tgtakaoka/Cyborg09/CyborgHD6309E/Prototype3/schematic/Prototype3.kicad_pcb

## KiCad design CyborgHD6309E/Prototype3/schematic/Prototype3.kicad_pcb (2021-06-11, an earlier design)

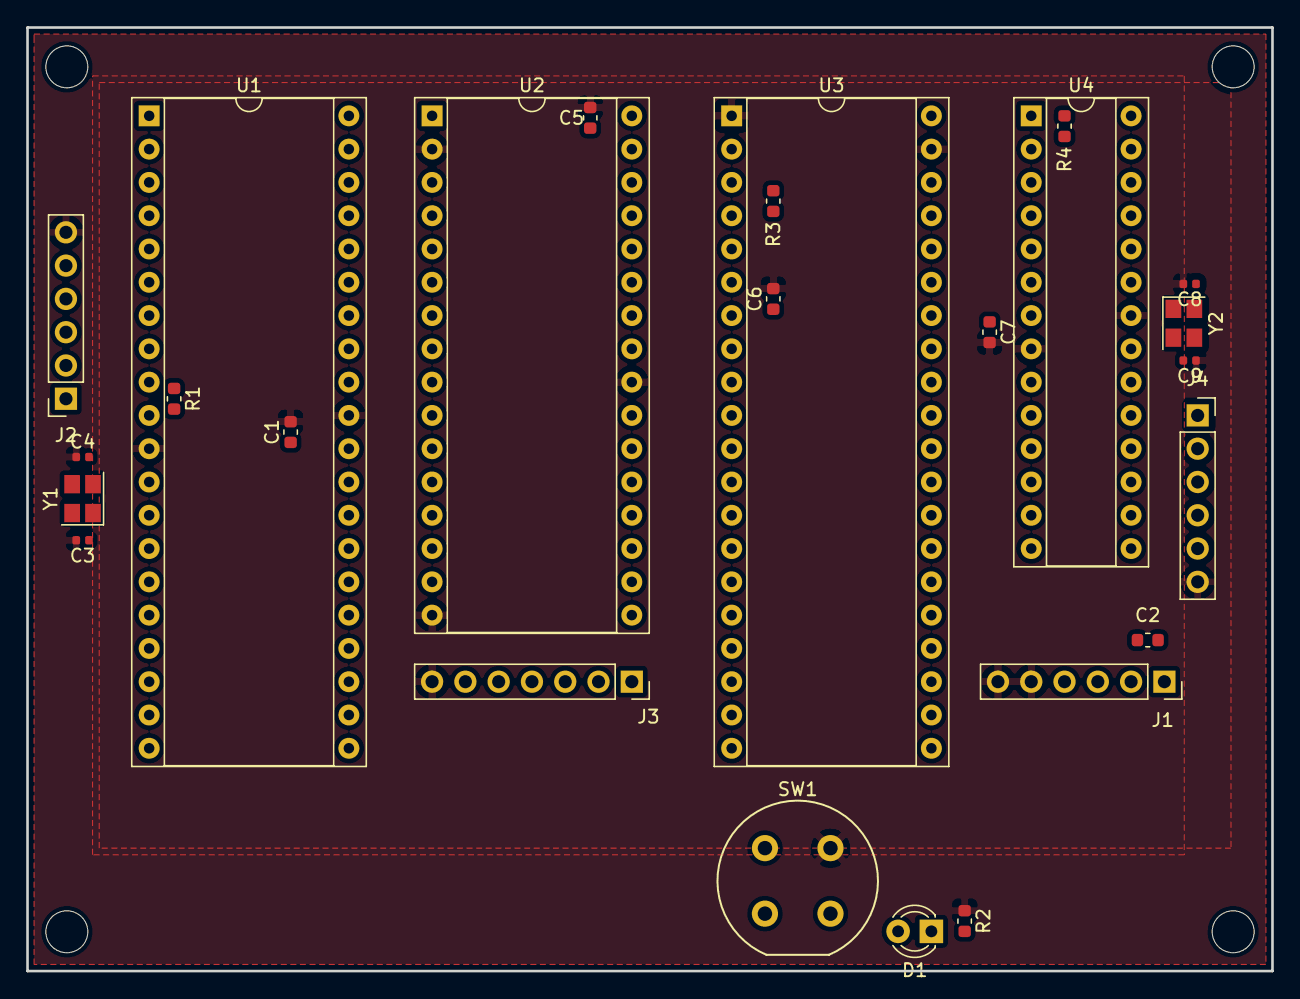
[picture p1: board Prototype3.kicad_pcb from above]

Board: 2 copper layers, 95.0 x 72.0 mm, 29 parts (0 on the bottom side), 59 nets, no tracks yet.

Parts:
C1, C2, C5, C6, C7: 0.1u; C_0603_1608Metric
C3, C4, C8, C9: 22p; C_0402_1005Metric
D1: USR_LED; LED_D3.0mm
J1: Conn_USB_Serial; PinSocket_1x06_P2.54mm_Vertical
J2, J4: Conn_AVR_ISP; PinSocket_1x06_P2.54mm_Vertical
J3: Conn_Micro_SD; PinSocket_1x07_P2.54mm_Vertical
MH1, MH2, MH3, MH4: MountingHole_3.2mm_M3
R1, R3, R4: 10k; R_0603_1608Metric
R2: 560; R_0603_1608Metric
SW1: USR_SW; Push_E-Switch_KS01Q01
U1: ATmega1284P-PU; DIP-40_W15.24mm_Socket
U2: HM628128DLP-5; DIP-32_W15.24mm_Socket
U3: HD63C09E; DIP-40_W15.24mm_Socket
U4: ATmega328P-PU; DIP-28_W7.62mm_Socket
Y1, Y2: 20MHz; Crystal_SMD_SeikoEpson_FA238-4Pin_3.2x2.5mm

Connections:
/A0: U1.3, U2.12, U3.8
/A1: U1.4, U2.11, U3.9
/A2: J4.4, U2.10, U3.10, U4.18
/A3: J4.5, U2.9, U3.11, U4.17
/A4: U2.8, U3.12, U4.16
/A5: U2.7, U3.13, U4.2
/A6: U2.6, U3.14, U4.15
/A7: J4.3, U2.5, U3.15, U4.19
/A8: U2.27, U3.16, U4.14
/A9: U2.26, U3.17, U4.3
/A10: U2.23, U3.18, U4.4
/A11: U2.25, U3.19, U4.5
/A12: U2.4, U3.20, U4.6
/A13: U2.28, U3.21, U4.11
/A14: U2.3, U3.22, U4.12
/A15: U2.31, U3.23, U4.13
/AVMA: U1.26, U3.36
/BA: U1.27, U3.6
/BS: U1.29, U3.5
/BUSY: U1.25, U3.33
/D0: U1.40, U2.13, U3.31
/D1: U1.39, U2.14, U3.30
/D2: U1.38, U2.15, U3.29
/D3: U1.37, U2.17, U3.28
/D4: U1.36, U2.18, U3.27
/D5: U1.35, U2.19, U3.26
/D6: U1.34, U2.20, U3.25
/D7: U1.33, U2.21, U3.24
/DBG_RX: J1.3, U1.14
/DBG_TX: J1.2, U1.15
/E_CLK: U2.30, U3.34, U4.27
/LIC: U1.28, U3.38
/Q_CLK: U3.35, U4.28
/RD_WR: U1.24, U2.29, U3.32
/SD_DI: J2.5, J3.3, U1.6
/SD_DO: J2.4, J3.5, U1.7
/SD_SCK: J2.3, J3.4, U1.8
/USR_LED: D1.2, U1.18
/~ACK~: U1.20, U4.25
/~DBG_RST~: C2.2, J2.1, R1.1, U1.9
/~HALT~: U1.23, U3.40
/~INT~: U1.17, U4.26
/~IRQ: U1.2, U3.3
/~NMI~: U1.1, U3.2
/~RAM_E~: U1.19, U2.22
/~RESET~: U1.22, U3.37
/~SD_CS~: J3.2, U1.5
/~STEP~: U1.21, U4.24
/~USR_SW~: SW1.1, U1.16
GND: C1.2, C3.2, C4.1, C5.2, C6.2, C7.2, C8.2, C9.1, J1.5, J1.6, J2.6, J3.7, J4.6, R2.1, SW1.2, U1.11, U1.31, U2.2, U2.16, U2.24, U3.1, U3.39, U4.8, U4.22
unnamed: C2.1, J1.1
unnamed: C3.1, U1.13, Y1.1
unnamed: C4.2, U1.12, Y1.2
unnamed: C8.1, U4.9, Y2.1
unnamed: C9.2, U4.10, Y2.2
unnamed: D1.1, R2.2
unnamed: J4.1, R4.1, U4.1
unnamed: R3.1, U3.4
VCC: C1.1, C5.1, C6.1, C7.1, J1.4, J2.2, J3.1, J4.2, R1.2, R3.2, R4.2, U1.10, U1.30, U2.32, U3.7, U4.7, U4.20
