tgtakaoka/Cyborg09/CyborgHD6309E/Prototype4/schematic/Prototype4.kicad_pcb

## KiCad design CyborgHD6309E/Prototype4/schematic/Prototype4.kicad_pcb (2021-06-11, an earlier design)

Schematic: Prototype4.sch, CyborgHD6309E Prototype4

Parts:
B1: Micro_SD; uSD_CARD
B2: USB_Serial; GY232V2
C1, C2, C3, C4, C5, C6, C7: 0.1u; C_Disc_D3.4mm_W2.1mm_P2.50mm
J1: Conn_AVR_UPDI; PinSocket_1x03_P2.54mm_Vertical
R2, R3: 10k; R_Axial_DIN0204_L3.6mm_D1.6mm_P5.08mm_Horizontal
R6: 560; R_Axial_DIN0204_L3.6mm_D1.6mm_P5.08mm_Horizontal
SW1: TSD1265; SW_PUSH-LED-12mm
U1: ATmega4809-P; DIP-40_W15.24mm
U2: HM628128DLP-5; DIP-32_W15.24mm_Socket
U3: HD63C09E; DIP-40_W15.24mm_Socket
U4: ATtiny412-SS; DIP-8_W7.62mm
U5: CD74HCT30; DIP-14_W7.62mm
U6: CD74HCT688; DIP-20_W7.62mm

Connections:
/A0: U1.7 (PC4), U2.26 (A9), U3.8 (A0)
/A1: U1.8 (PC5), U2.25 (A11), U3.9 (A1)
/A2: U2.23 (A10), U3.10 (A2)
/A3: U2.3 (A14), U3.11 (A3), U6.17 (A7)
/A4: U2.4 (A12), U3.12 (A4), U6.15 (A6)
/A5: U2.5 (A7), U3.13 (A5), U6.13 (A5)
/A6: U2.6 (A6), U3.14 (A6), U6.11 (A4)
/A7: U2.7 (A5), U3.15 (A7), U6.8 (A3)
/A8: U2.8 (A4), U3.16 (A8), U5.12
/A9: U2.9 (A3), U3.17 (A9), U5.11
/A10: U2.10 (A2), U3.18 (A10), U5.1
/A11: U2.11 (A1), U3.19 (A11), U5.2
/A12: U2.12 (A0), U3.20 (A12), U5.3
/A13: U2.27 (A8), U3.21 (A13), U5.6
/A14: U2.28 (A13), U3.22 (A14), U5.5
/A15: U2.31 (A15), U3.23 (A15), U5.4
/AVMA: U1.12 (PD3), U3.36 (AVMA)
/BA: U1.14 (PD5), U3.6 (BA)
/BS: U1.13 (PD4), U3.5 (BS)
/BUSY: U1.16 (PD7), U3.33 (BUSY)
/D0: U1.33 (PA0), U2.21 (Q7), U3.31 (D0)
/D1: U1.34 (PA1), U2.20 (Q6), U3.30 (D1)
/D2: U1.35 (PA2), U2.19 (Q5), U3.29 (D2)
/D3: U1.36 (PA3), U2.18 (Q4), U3.28 (D3)
/D4: U1.37 (PA4), U2.17 (Q3), U3.27 (D4)
/D5: U1.38 (PA5), U2.13 (Q0), U3.26 (D5)
/D6: U1.39 (PA6), U2.14 (Q1), U3.25 (D6)
/D7: U1.40 (PA7), U2.15 (Q2), U3.24 (D7)
/DBG_RX: B2.4 (TXD), U1.1 (PC0/TXD)
/DBG_TX: B2.5 (RXD), U1.2 (PC1/RXD)
/E_CLK: U2.30 (CS2), U3.34 (E), U4.3 (PA7)
/LIC: U1.10 (PD1), U3.38 (LIC)
/Q_CLK: U3.35 (Q), U4.4 (PA1)
/RD_WR: U1.11 (PD2), U2.29 (WR), U3.32 (R/~W)
/SD_DI: B1.3 (DI), U1.19 (MOSI/PE0)
/SD_DO: B1.5 (DO), U1.20 (MISO/PE1)
/SD_SCK: B1.4 (SCK), U1.21 (SCK/PE2)
/USR_LED: R6.2, U1.27 (PF4)
/~ACK~: U1.3 (PC2/SDA), U4.6 (UPDI/PA0)
/~DBG_RESET~: C7.2, R3.1, U1.29 (~RESET~/PF6)
/~HALT~: U1.15 (PD6), U3.40 (~HALT)
/~INT~: U1.25 (PF2), U4.7 (PA3)
/~IRQ~: U1.23 (PF0), U3.3 (~IRQ)
/~NMI~: U1.24 (PF1), U3.2 (~NMI)
/~RAM_E~: U1.4 (PC3/SCL), U2.22 (CS1)
/~RESET~: U1.9 (PD0), U3.37 (~RESET)
/~SD_CS~: B1.2 (~CS), U1.22 (SS/PE3)
/~STEP~: U1.26 (PF3), U4.5 (PA2)
/~USR_SW~: SW1.2, U1.28 (PF5)
GND: B1.7 (GND), B2.1 (GND), B2.2 (~CTS~), C1.2, C2.2, C3.2, C4.2, C5.2, C6.2, J1.2 (GND), SW1.1, SW1.3 (K), U1.6 (GND), U1.18 (GND), U1.32 (GND), U2.2 (A16), U2.16 (GND), U2.24 (OE), U3.1 (VSS), U3.39 (TSC), U4.8 (GND), U5.7 (GND), U6.2 (A0), U6.3 (B0), U6.4 (A1), U6.5 (B1), U6.6 (A2), U6.7 (B2), U6.10 (GND), U6.14 (B5), U6.16 (B6), U6.18 (B7)
unnamed: B2.6 (~DTR~), C7.1
unnamed: J1.1 (UPDI), U1.30 (UPDI)
unnamed: R2.2, U3.4 (~FIRQ)
unnamed: R6.1, SW1.4 (A)
unnamed: U4.2 (PA6), U6.19 (~Y~)
unnamed: U5.8, U6.1 (~E~)
VCC: B1.1 (VCC), B2.3 (5V0), C1.1, C2.1, C3.1, C4.1, C5.1, C6.1, J1.3 (VCC), R2.1, R3.2, U1.5 (VCC), U1.17 (AVCC), U1.31 (VCC), U2.32 (VCC), U3.7 (VCC), U4.1 (VCC), U5.14 (VCC), U6.9 (B3), U6.12 (B4), U6.20 (VCC)

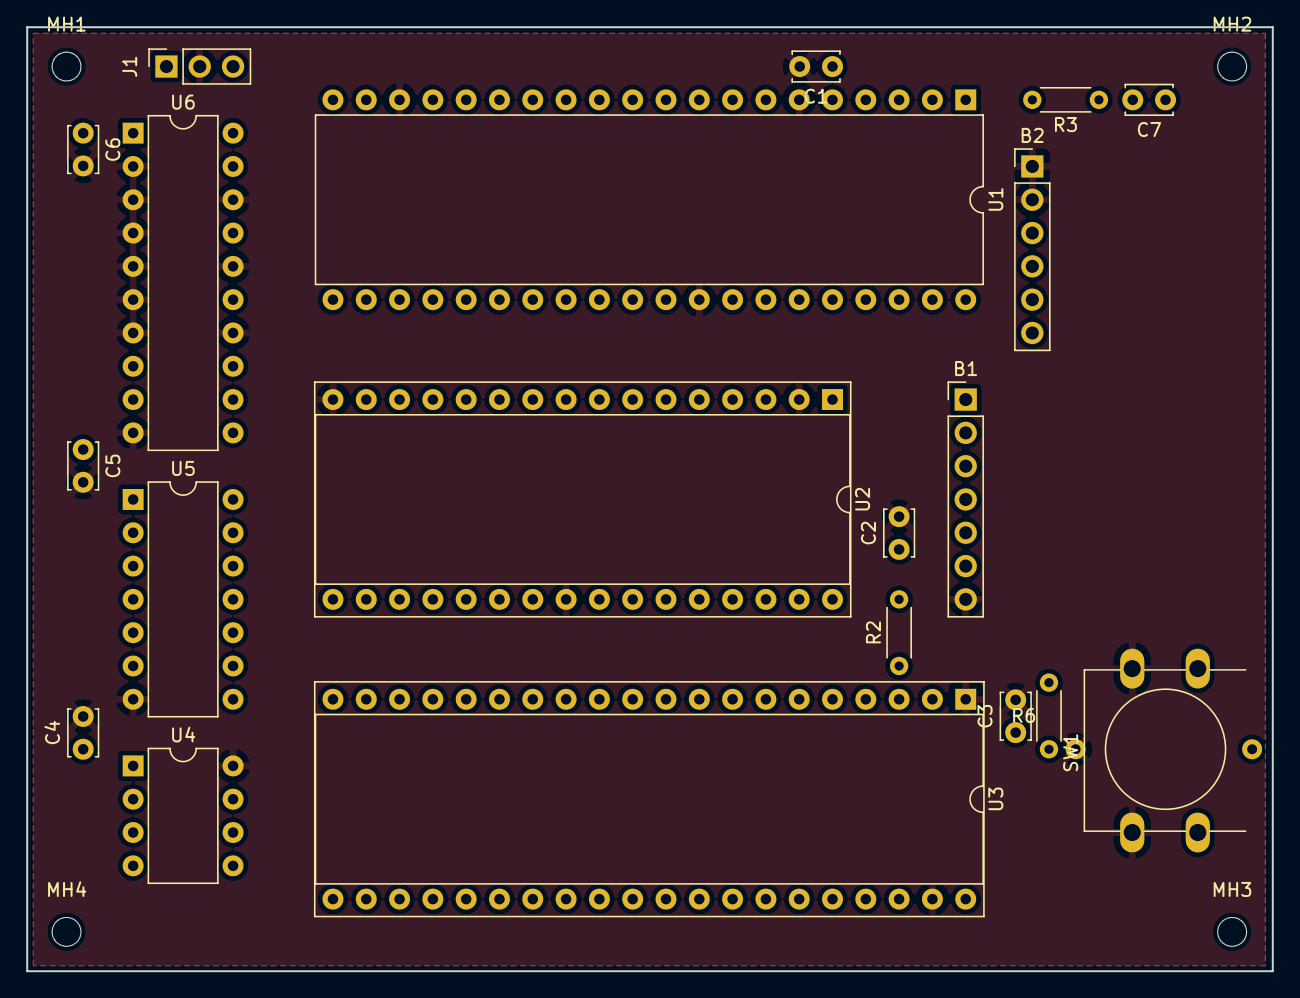
[picture p2: board Prototype4.kicad_pcb from above]

Board: 2 copper layers, 95.0 x 72.0 mm, 24 parts (0 on the bottom side), 57 nets, no tracks yet.

Other parts of the board:
MH1, MH2, MH3, MH4: MountingHole_2.2mm_M2
