tgtakaoka/Cyborg09/BionicHD6303/schematic/Prototype1.kicad_pcb

## KiCad design BionicHD6303/schematic/Prototype1.kicad_pcb (2021-01-31)

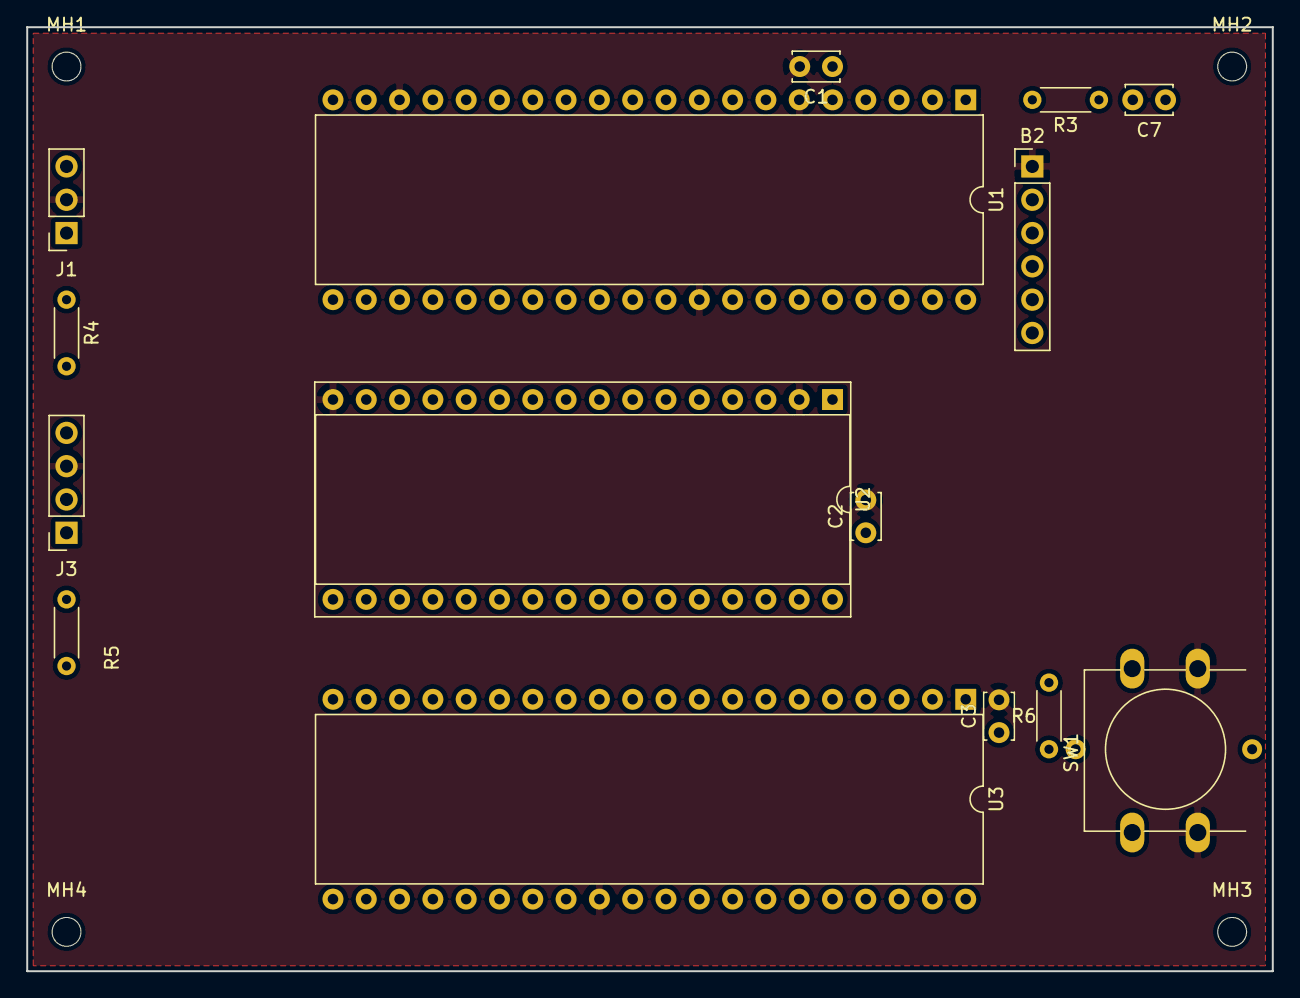
[picture p3: board Prototype1.kicad_pcb from above]

Board: 2 copper layers, 95.0 x 72.0 mm, 19 parts (0 on the bottom side), 50 nets, no tracks yet.

Parts:
B2: USB_Serial; GY232V2
C1, C2, C3, C7: 0.1u; C_Disc_D3.4mm_W2.1mm_P2.50mm
J1: Conn_AVR_UPDI; PinSocket_1x03_P2.54mm_Vertical
J3: Conn_I2C_Master; PinSocket_1x04_P2.54mm_Vertical
MH1, MH2, MH3, MH4: MountingHole_2.2mm_M2
R3: 10k; R_Axial_DIN0204_L3.6mm_D1.6mm_P5.08mm_Horizontal
R4, R5: 4k7; R_Axial_DIN0204_L3.6mm_D1.6mm_P5.08mm_Horizontal
R6: 560; R_Axial_DIN0204_L3.6mm_D1.6mm_P5.08mm_Horizontal
SW1: TSD1265; SW_PUSH-LED-12mm
U1: ATmega4809-P; DIP-40_W15.24mm
U2: HM628128DLP-5; DIP-32_W15.24mm_Socket
U3: Z84C00; DIP-40_W15.24mm

Connections:
/A0: U1.25, U2.26, U3.30
/A1: U1.26, U2.25, U3.31
/A2: U2.23, U3.32
/A3: U2.3, U3.33
/A4: U2.4, U3.34
/A5: U2.5, U3.35
/A6: U2.6, U3.36
/A7: U2.7, U3.37
/A8: U2.8, U3.38
/A9: U2.9, U3.39
/A10: U2.10, U3.40
/A11: U2.11, U3.1
/A12: U2.12, U3.2
/A13: U2.27, U3.3
/A14: U2.28, U3.4
/A15: U2.31, U3.5
/CLK: U1.28, U3.6
/D0: U1.9, U2.21, U3.14
/D1: U1.10, U2.20, U3.15
/D2: U1.11, U2.19, U3.12
/D3: U1.12, U2.18, U3.8
/D4: U1.13, U2.17, U3.7
/D5: U1.14, U2.13, U3.9
/D6: U1.15, U2.14, U3.10
/D7: U1.16, U2.15, U3.13
/DBG_RX: B2.4, U1.1
/DBG_TX: B2.5, U1.2
/SCL: J3.4, R4.2
/SDA: J3.1, R5.2
/~BUSACK~: U1.40, U3.23
/~BUSREQ~: U1.39, U3.25
/~DBG_RESET~: C7.2, R3.1, U1.29
/~DBG_RTS~: B2.2, U1.8
/~INT~: U1.23, U3.16
/~IORQ~: U1.33, U3.20
/~M1~: U1.35, U3.27
/~MREQ~: U1.34, U3.19
/~NMI~: U1.24, U3.17
/~RAM_E~: U1.3, U2.22
/~RD~: U1.37, U2.24, U3.21
/~RESET~: U1.27, U3.26
/~USR_LED~: R6.2, U1.7
/~USR_SW~: SW1.1, U1.4
/~WAIT~: U1.36, U3.24
/~WR~: U1.38, U2.29, U3.22
GND: B2.1, C1.2, C2.2, C3.2, J1.2, J3.3, SW1.2, U1.6, U1.18, U1.32, U2.2, U2.16, U3.29
unnamed: B2.6, C7.1
unnamed: J1.1, U1.30
unnamed: R6.1, SW1.3
VCC: B2.3, C1.1, C2.1, C3.1, J1.3, J3.2, R3.2, R4.1, R5.1, SW1.4, U1.5, U1.17, U1.31, U2.30, U2.32, U3.11
