tgtakaoka/Cyborg09/CyborgHD6309E/Prototype5/debugger/debugger.ino

/* -*- mode: c++; c-basic-offset: 4; tab-width: 4; -*- */
/**
 *  CyborgHD6309E controller
 *
 * This sketch is designed to controll and debug MC6809E/HD6309E MPU.
 */

#include <libcli.h>

#include "commands.h"
#include "pins.h"

libcli::Cli Cli;

void setup() {
    Pins.begin();
    Commands.begin();
    interrupts();
}

void loop() {
    if (Pins.isRunning()) {
        Pins.loop();
    } else {
        Cli.loop();
        Commands.loop();
    }
}
