tgtakaoka/Cyborg09/(commit log)

2021-01-31 [BionicHD6303] Add prototype schematic
    [Prototype1.kicad_pcb, Prototype1.sch]
2021-02-17 [BionicHD6303] Add clock generator test running on Teensy 3.5
2021-02-17 [CyborgHD6309E] Update pins map
    [Prototype4.kicad_pcb, Prototype4.sch]
2021-02-17 [CyborgHD6309E] Restore Prototype3
    [Prototype3.kicad_pcb, Prototype3.sch]
2021-02-17 [CyborgHD6309E] Update Prototype3 to libcli 1.0.4
    [Prototype3.sch]
2021-02-17 [CyborgHD6309E] Reorganize Prototype4
    [Prototype4.kicad_pcb, Prototype4.sch]
2021-02-17 [CyborgHD6309E] Update Prototype4 pins to compatible with Prototype5
2021-02-17 [CyborgHD6309E] Add Prototype5
    [Prototype5.kicad_pcb, Prototype5.sch]
2021-02-17 [CynorgHD6309E] Add board pin map
2021-02-17 [CyborgHD6309E] Update Prototype3 pins
    [Prototype3.kicad_pcb, Prototype3.sch]
2021-02-17 [CyborgHD6309E] Prototype3 modify pins map
2021-02-17 [CyborgHD6309E] Update Prototype3 debugger to 2.1.0
    Import debugger from Prototype4 and now Prototype can handle HD6309E
    correctly.
    [commands.cpp, debugger.ino, mc6850.cpp, pins.cpp, pins.h, regs.cpp, regs.h]
2021-03-27 [CyborgHD6309E] Consolidate Prototype3/4 debugger
2021-03-27 [CyborgHD6309E] Modify Prototype4 pin maps to upcomming Prototype5
    [Prototype4.kicad_pcb, Prototype4.sch]
2021-03-27 [CyborgHD6309E] Prototype4/cgen6309e PlatformIO supported
2021-03-27 [CyborgHD6309E] Add Prototype5 cgen6309e-test
2021-03-27 [CyborgHD6309E] Copy debugger to Prototype5
2021-06-11 [CyborgHD6309E] Prorotype5 debugger
    [Prototype3.kicad_pcb, Prototype4.kicad_pcb, Prototype5.kicad_pcb, Prototype5.sch]
